aesirkth/external-can/README.md

# External CAN
PCB design and Firmware for an external board that receives and transmits CAN data from the CAN bus.
