aesirkth/external-can/external_can_PCB/README.md

# Potential Component List

* STM32L562CET3P LQFP48 - STM32L5 series processor with 512K Flash, 256K RAM and 48 pins.
* SN65HVD230 - 3.3 V CAN Transceiver with Standby Mode
* JST-XH-4 - CAN side 4-pin connector for CANH, CANL, PWR, GND
* JST-XH-6 - SPI/I2C side 6-pin connector for PWR, GND, SPI_CLK, SPI_SS, SPI_MISO, SPI MOSI
* Possibly SD CARD connector
