aesirkth/external-can/external_can_PCB/ECAN.kicad_pcb

## KiCad design external_can_PCB/ECAN.kicad_pcb (2024-02-22)

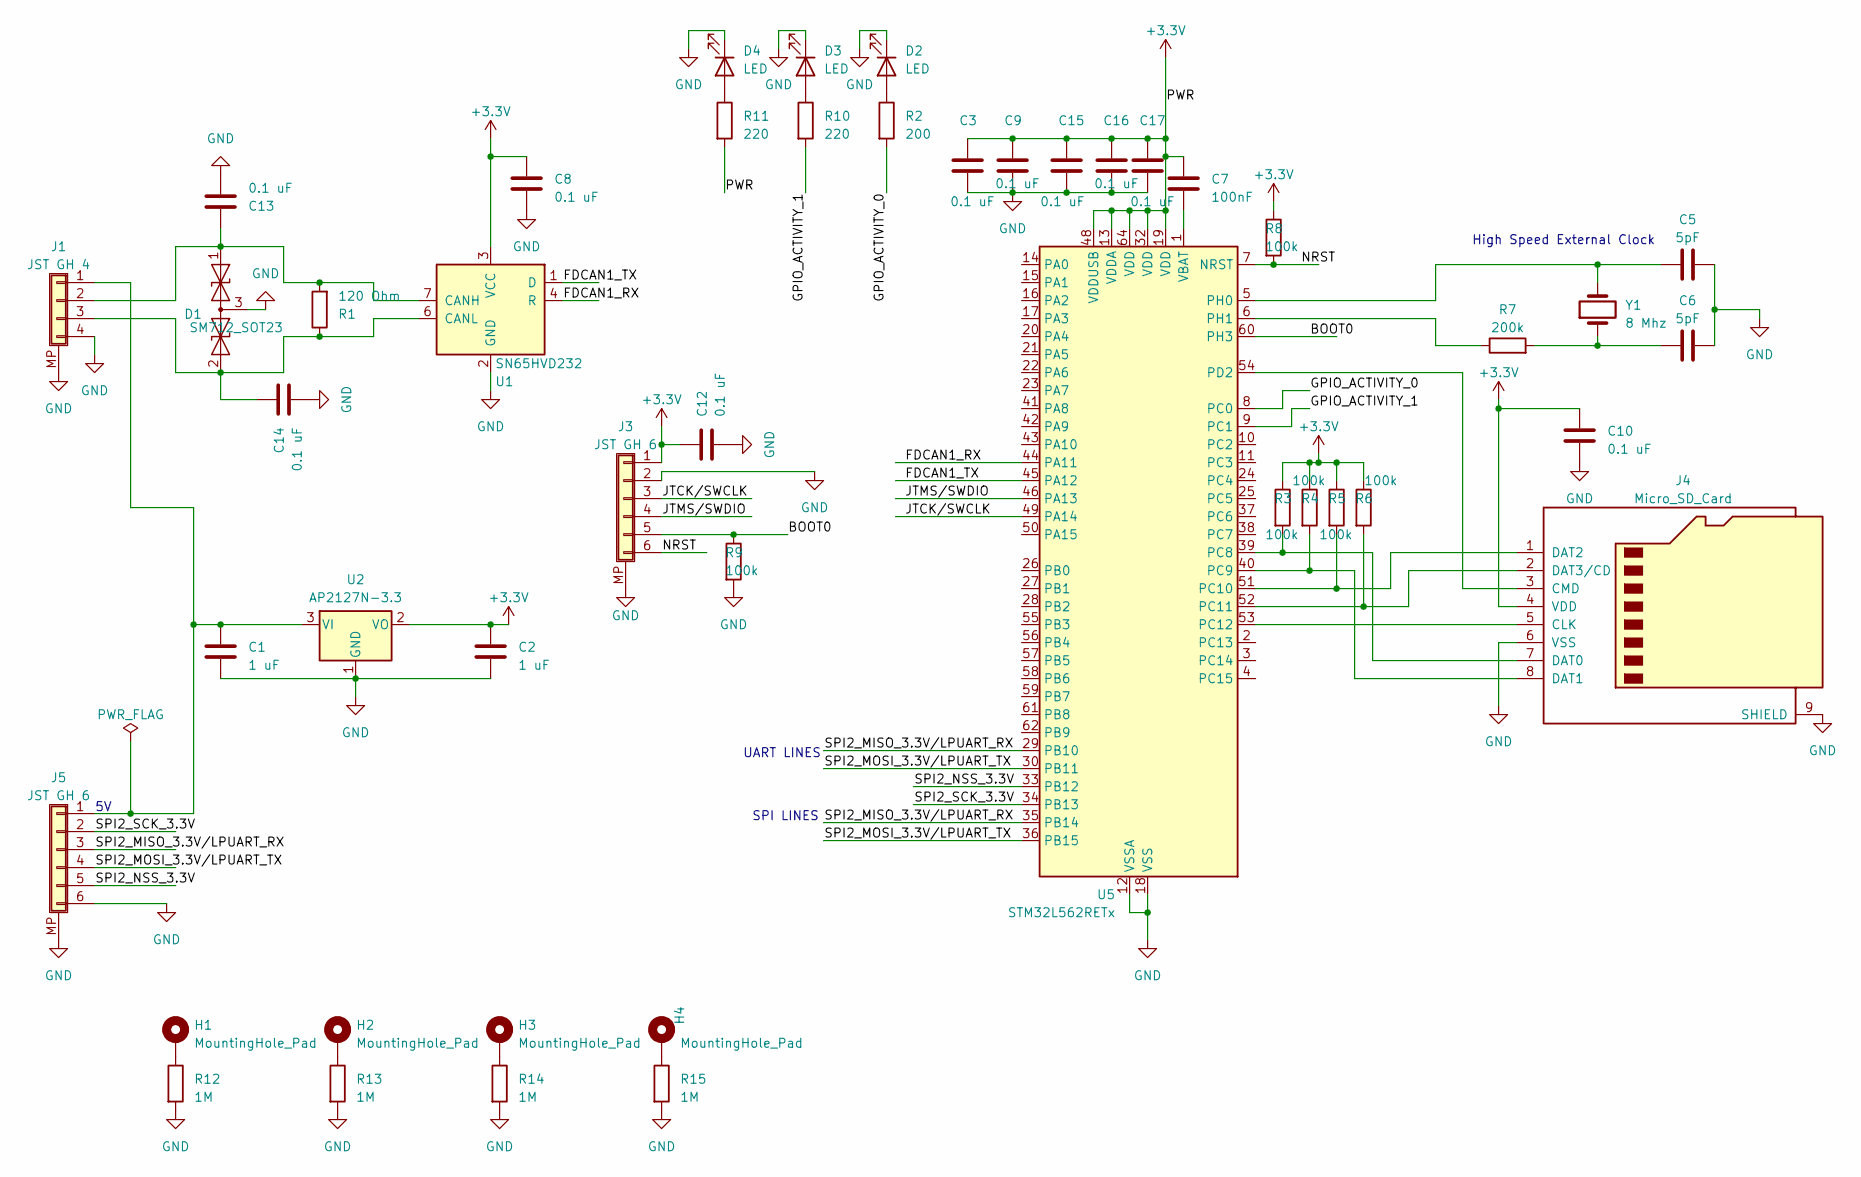
[picture p1: schematic ECAN.kicad_sch]

Parts:
C1, C2: 1 uF; C_0402_1005Metric_Pad0.74x0.62mm_HandSolder
C3, C8, C9, C10, C12, C13, C14, C15, C16, C17: 0.1 uF; C_0402_1005Metric_Pad0.74x0.62mm_HandSolder
C5, C6: 5pF; C_0402_1005Metric_Pad0.74x0.62mm_HandSolder
C7: 100nF; C_0402_1005Metric_Pad0.74x0.62mm_HandSolder
D1: SM712_SOT23; SOT-23
D2, D3, D4: LED; LED_0805_2012Metric_Pad1.15x1.40mm_HandSolder
H1, H2, H3, H4: MountingHole_Pad; MountingHole_3.2mm_M3_DIN965_Pad
J1: JST GH 4; JST_GH_SM04B-GHS-TB_1x04-1MP_P1.25mm_Horizontal
J3, J5: JST GH 6; JST_GH_SM06B-GHS-TB_1x06-1MP_P1.25mm_Horizontal
J4: Micro_SD_Card; microSD_HC_Wuerth_693072010801
R1: 120 Ohm; R_0402_1005Metric_Pad0.72x0.64mm_HandSolder
R2: 200; R_0402_1005Metric_Pad0.72x0.64mm_HandSolder
R3, R4, R5, R6, R8, R9: 100k; R_0402_1005Metric_Pad0.72x0.64mm_HandSolder
R7: 200k; R_0402_1005Metric_Pad0.72x0.64mm_HandSolder
R10, R11: 220; R_0402_1005Metric_Pad0.72x0.64mm_HandSolder
R12, R13, R14, R15: 1M; R_0603_1608Metric_Pad0.98x0.95mm_HandSolder
U1: SN65HVD232; SOIC-8_3.9x4.9mm_P1.27mm
U2: AP2127N-3.3; SOT-223-3_TabPin2
U5: STM32L562RETx; LQFP-64_10x10mm_P0.5mm
Y1: 8 Mhz; Crystal_SMD_0603-2Pin_6.0x3.5mm_HandSoldering

Connections:
+3.3V: C2.1, C3.1, C7.2, C8.1, C9.1, C10.1, C12.1, C15.1, C16.1, C17.1, J3.1, J4.4 (VDD), R3.1, R4.1, R5.1, R6.1, R8.1, R11.2, U1.3 (VCC), U2.2 (VO), U5.13 (VDDA), U5.19 (VDD), U5.32 (VDD), U5.48 (VDDUSB), U5.64 (VDD)
/BOOT0: J3.5, R9.1, U5.60 (PH3)
/FDCAN1_RX: U1.4 (R), U5.44 (PA11)
/FDCAN1_TX: U1.1 (D), U5.45 (PA12)
/GPIO_ACTIVITY_0: R2.2, U5.8 (PC0)
/GPIO_ACTIVITY_1: R10.2, U5.9 (PC1)
/JTCK/SWCLK: J3.3, U5.49 (PA14)
/JTMS/SWDIO: J3.4, U5.46 (PA13)
/NRST: J3.6, R8.2, U5.7 (NRST)
/SPI2_MISO_3.3V/LPUART_RX: J5.3, U5.29 (PB10), U5.35 (PB14)
/SPI2_MOSI_3.3V/LPUART_TX: J5.4, U5.30 (PB11), U5.36 (PB15)
/SPI2_NSS_3.3V: J5.5, U5.33 (PB12)
/SPI2_SCK_3.3V: J5.2, U5.34 (PB13)
GND: C1.2, C2.2, C3.2, C5.2, C6.2, C8.2, C9.2, C10.2, C12.2, C13.2, C14.2, C15.2, C16.2, C17.2, D1.3 (common), D2.1 (K), D3.1 (K), D4.1 (K), J1.4, J1.MP (Mount_Point), J3.2, J3.MP (Mount_Point), J4.6 (VSS), J4.9 (SHIELD), J5.6, J5.MP (Mount_Point), R9.2, R12.2, R13.2, R14.2, R15.2, U1.2 (GND), U2.1 (GND), U5.12 (VSSA), U5.18 (VSS), U5.31 (VSS), U5.47 (VSS), U5.63 (VSS)
unnamed: C1.1, J1.1, J5.1, U2.3 (VI)
unnamed: C6.1, R7.2, Y1.1
unnamed: C13.1, D1.1 (A1), J1.2, R1.2, U1.7 (CANH)
unnamed: C14.1, D1.2 (A2), J1.3, R1.1, U1.6 (CANL)
unnamed: D2.2 (A), R2.1
unnamed: D3.2 (A), R10.1
unnamed: D4.2 (A), R11.1
unnamed: H1.1, R12.1
unnamed: H2.1, R13.1
unnamed: H3.1, R14.1
unnamed: H4.1, R15.1
unnamed: J4.5 (CLK), U5.53 (PC12)
unnamed: J4.3 (CMD), U5.54 (PD2)
unnamed: J4.7 (DAT0), R3.2, U5.39 (PC8)
unnamed: J4.8 (DAT1), R4.2, U5.40 (PC9)
unnamed: J4.1 (DAT2), R5.2, U5.51 (PC10)
unnamed: J4.2 (DAT3/CD), R6.2, U5.52 (PC11)
unnamed: C5.1, U5.5 (PH0), Y1.2
unnamed: R7.1, U5.6 (PH1)
unnamed: C7.1, U5.1 (VBAT)

Notes on the sheet:
UART LINES
SPI LINES
High Speed External Clock

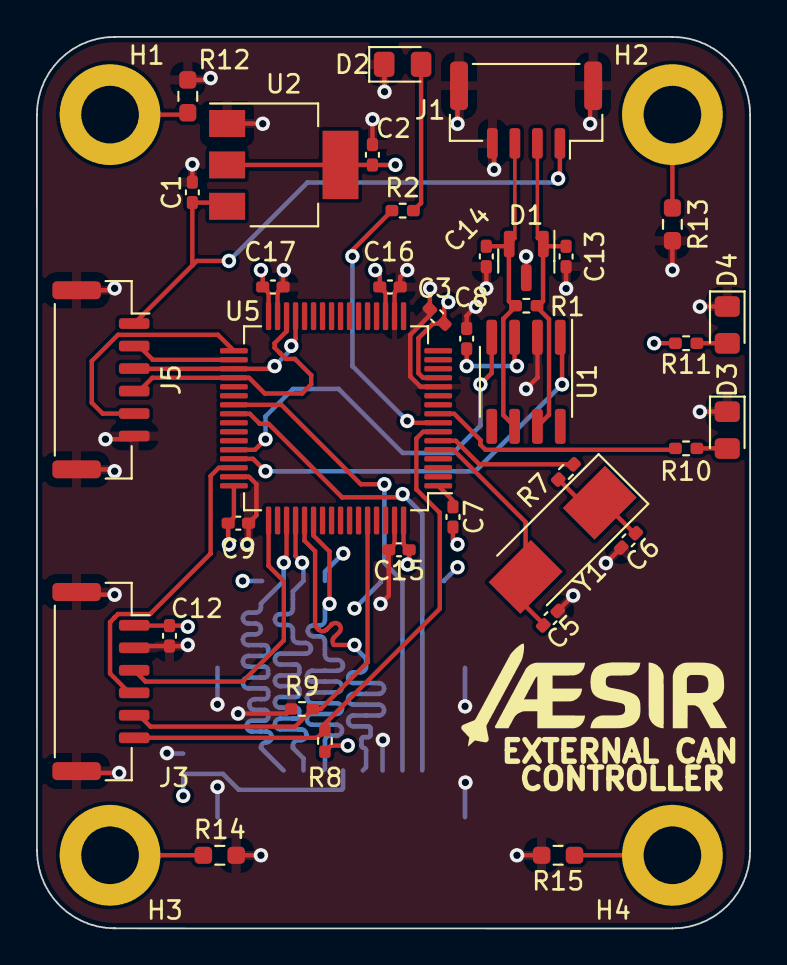
[picture p2: board ECAN.kicad_pcb from above]

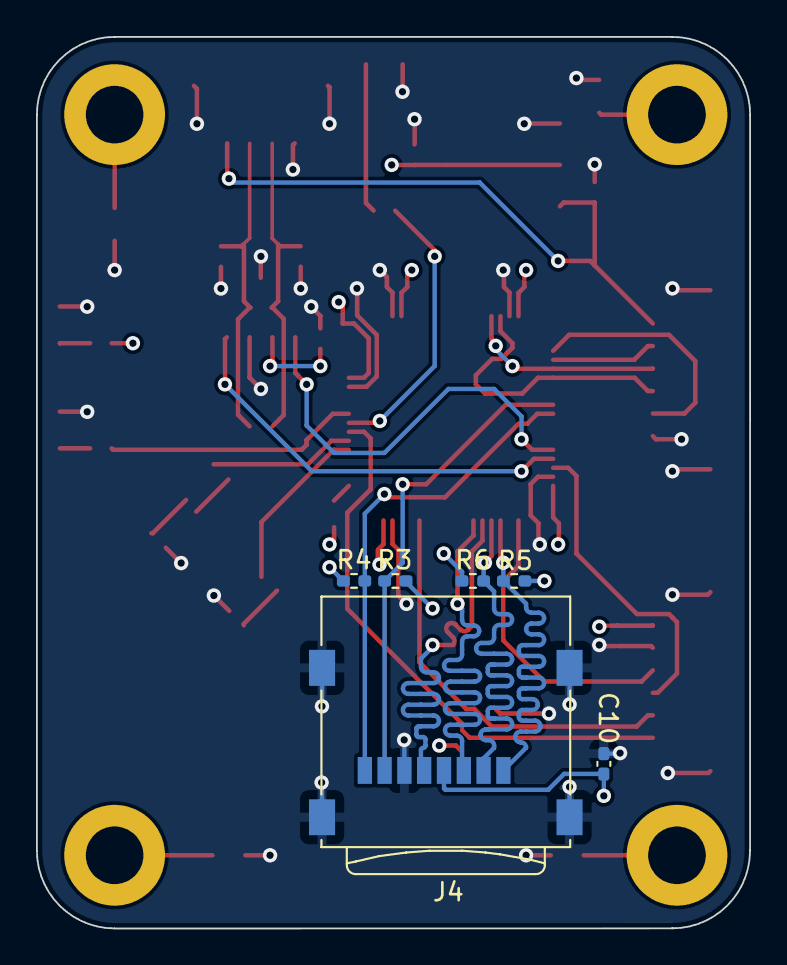
[picture p3: board ECAN.kicad_pcb from below]

Board: 4 copper layers, 39.6 x 49.5 mm, 46 parts (6 on the bottom side), 34 nets.
