aesirkth/external-can/(commit log)

2023-05-04 PCB component README
2023-05-04 Schematic First Version
    [ECAN.kicad_sch]
2023-05-11 Added voltage regulator for 5v->3v3 and Level shifter for SPI 3v3 to 5v
    [ECAN.kicad_sch]
2023-05-23 64 pin package addition (still needs to be connected as pins dont match with 48-pin version)
    [ECAN.kicad_sch]
2023-05-29 64-pin version replacement for stm32
    [ECAN.kicad_sch]
2023-09-18 PCB initial
    [ECAN.kicad_pcb, ECAN.kicad_sch]
2023-09-25 Added micro SD Card slot and oscillator
    [ECAN.kicad_pcb, ECAN.kicad_sch]
2023-09-26 Added HSE
    [ECAN.kicad_sch]
2023-10-10 PCB layout v1
    [ECAN.kicad_pcb, ECAN.kicad_sch]
2023-11-27 Redid ECAN Design: - Removed SPI Level Shifter * Changed JST SH Connector to JST GH * Cleaned up schematic
    [ECAN.kicad_pcb, ECAN.kicad_sch]
2023-12-12 Added screw holes and layer pours
    [ECAN.kicad_pcb, ECAN.kicad_sch]
2024-02-06 Addressed issues from Review by Olof
    [ECAN.kicad_pcb, ECAN.kicad_sch]
2024-02-13 GPIO LED changes and UART connection to SPI lines
    [ECAN.kicad_pcb, ECAN.kicad_sch]
2024-02-13 final length matching
    [ECAN.kicad_pcb]
2024-02-13 Bom fix
    [ECAN.csv]
2024-02-20 Changed CAN connecter reference to 5V, which allows the board to be powered through the CAN connector
    [ECAN.kicad_pcb, ECAN.kicad_sch]
2024-02-20 Updated BOM
    [ECAN.csv]
2024-02-22 ordered version
    [ECAN.kicad_pcb]
